jpconstantineau/PyKey60/pykey87/PCB-design/PyKey87.kicad_pcb

## KiCad design pykey87/PCB-design/PyKey87.kicad_pcb (2022-02-04)

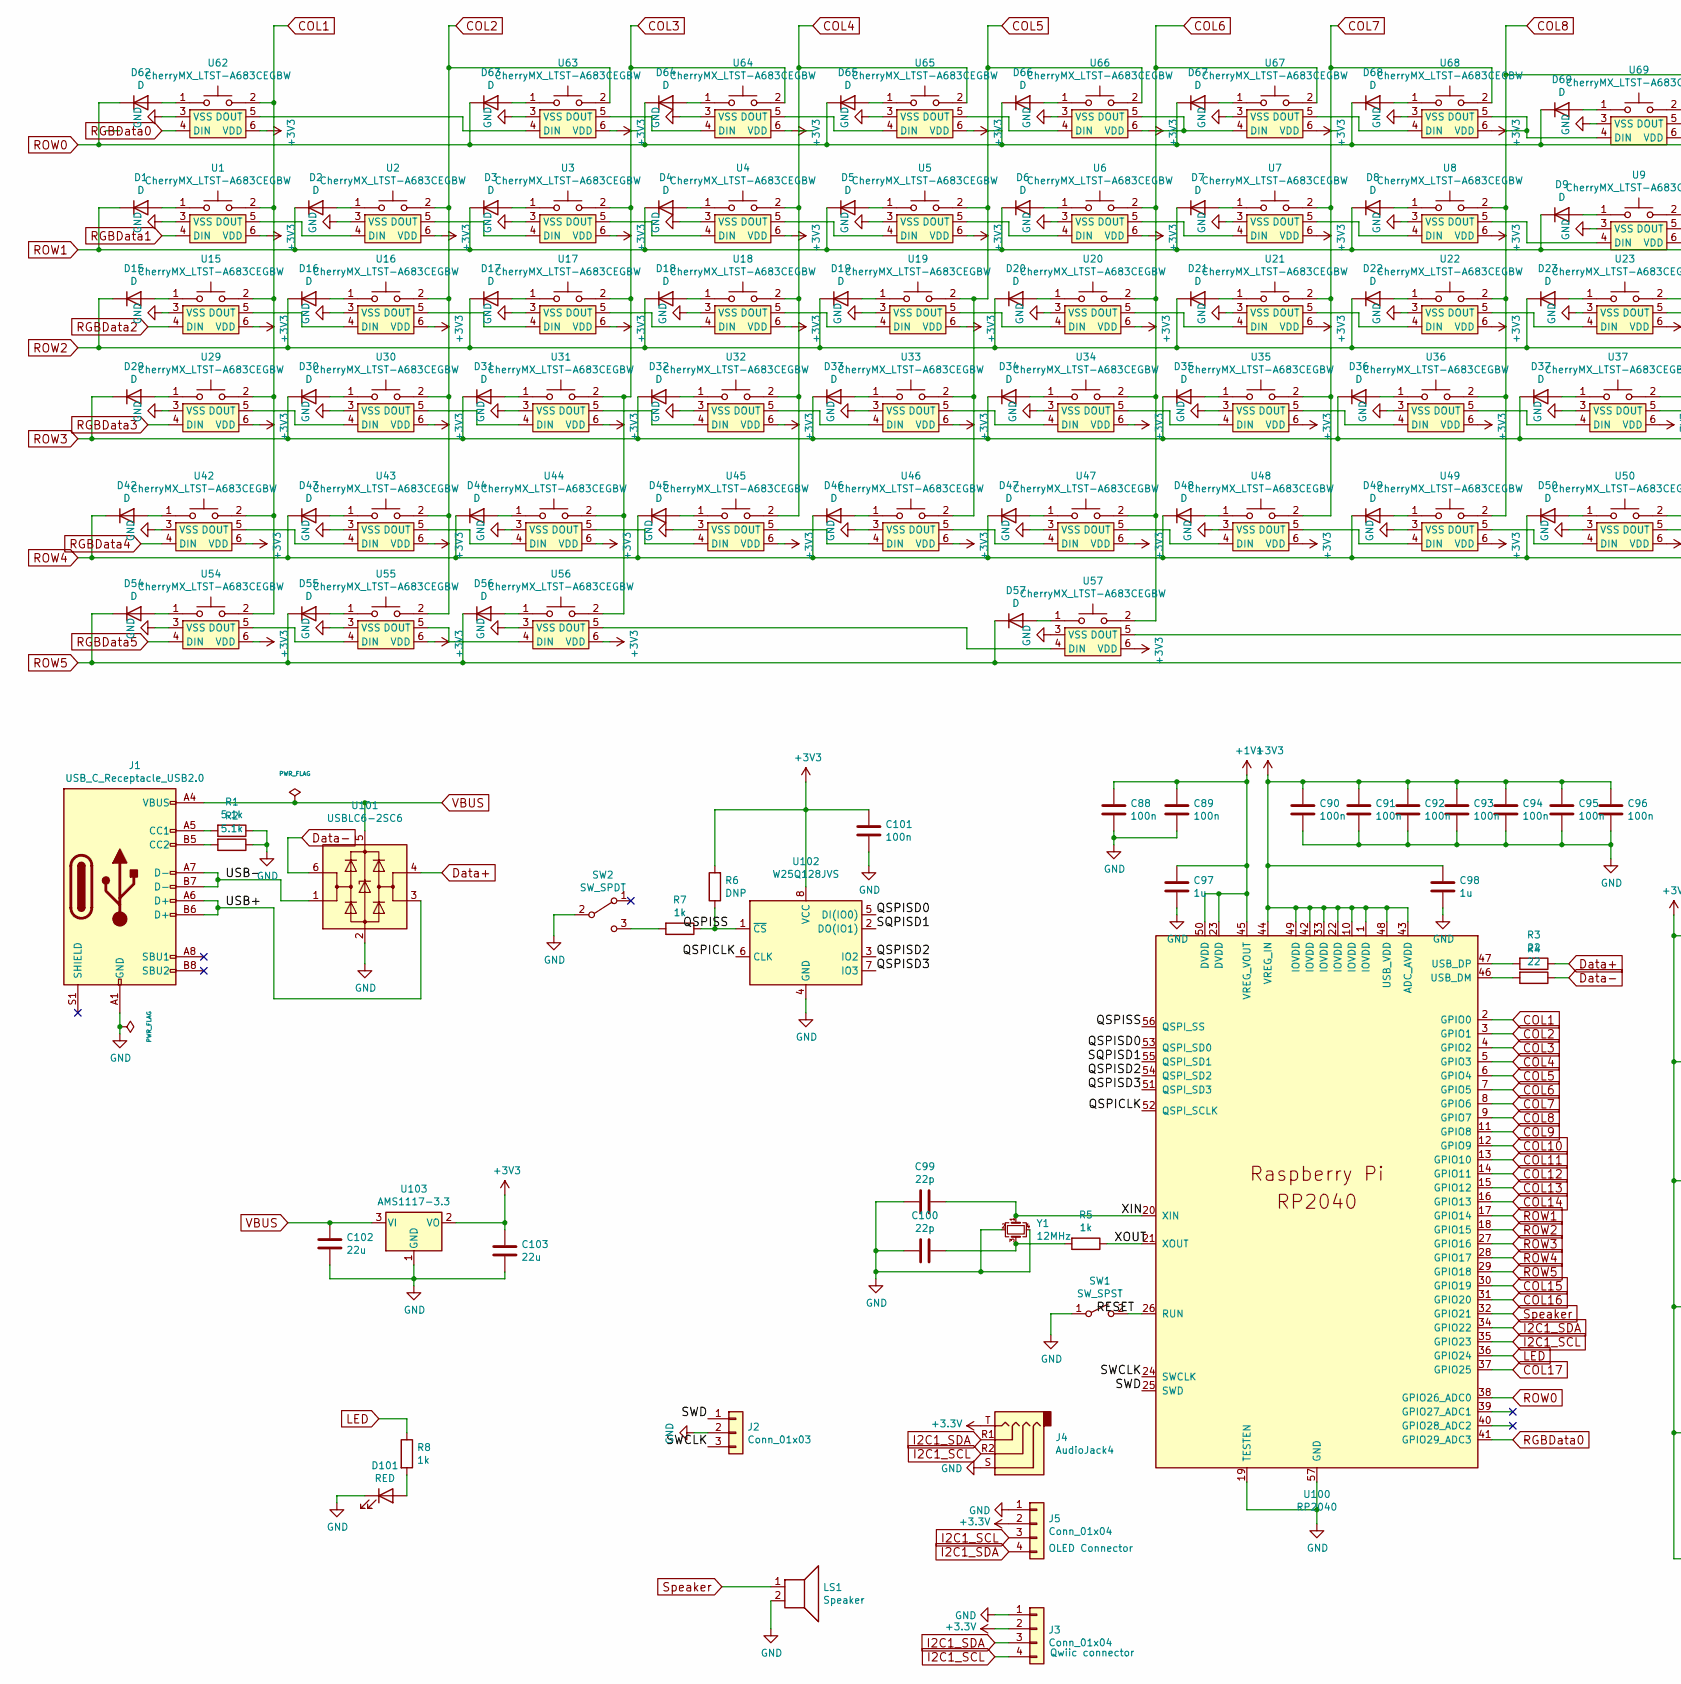
[picture p1: schematic PyKey87.sch, PyKey87 RP2040, part in row 1, column 1]

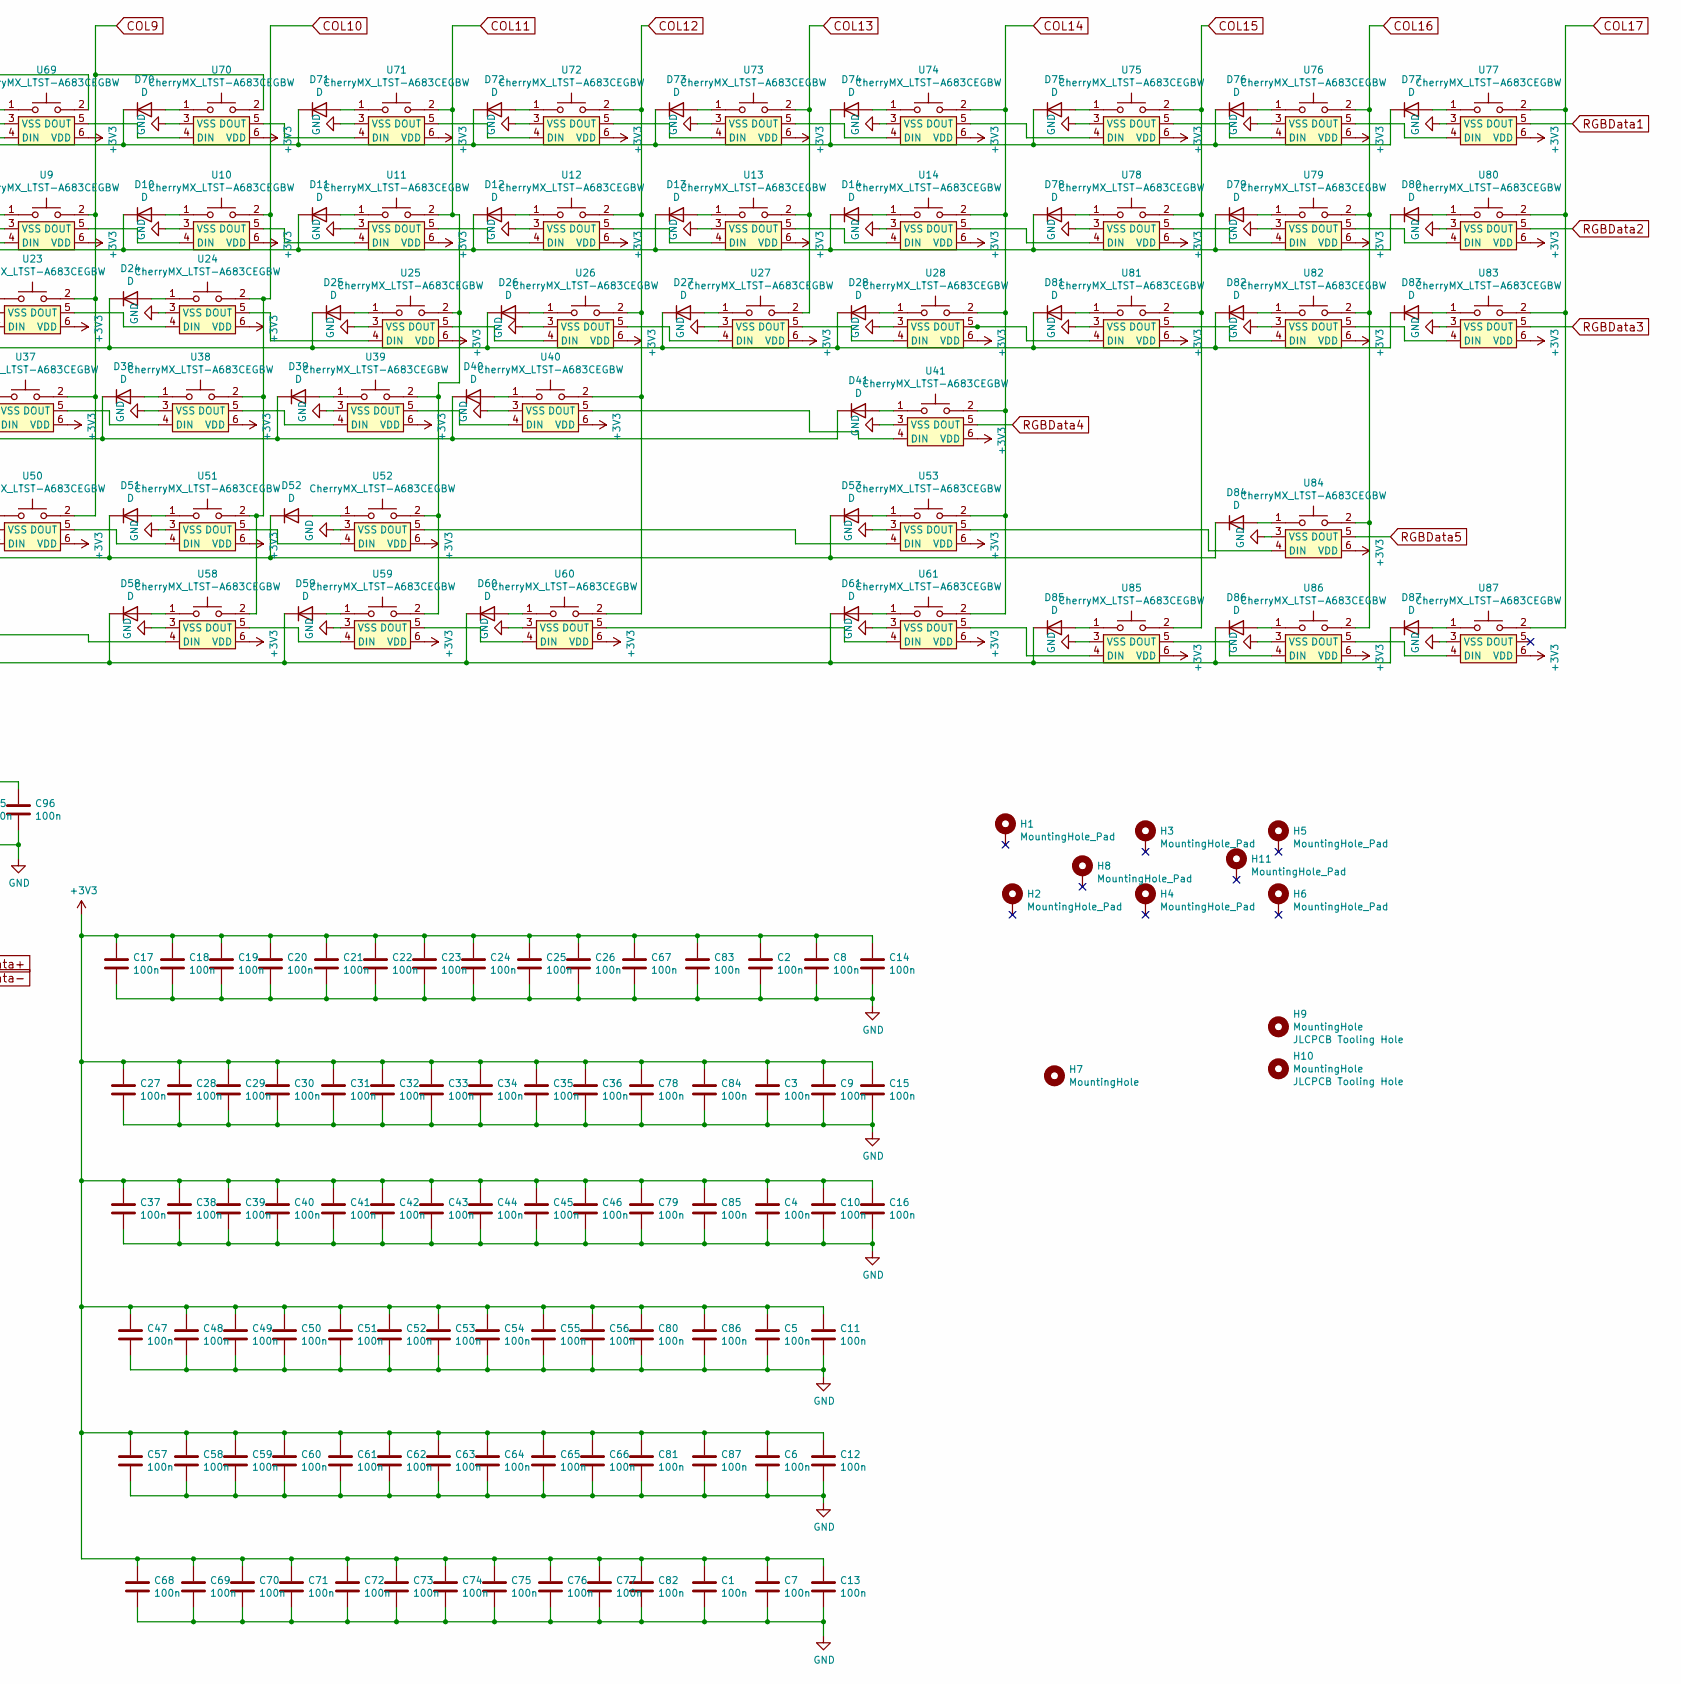
[picture p2: schematic PyKey87.sch, PyKey87 RP2040, part in row 1, column 2]

Parts:
C1, C2, C3, C4, C5, C6, C7, C8, C9, C10, C11, C12, C13, C14, C15, C16, C17, C18, C19, C20, C21, C22, C23, C24, C25, C26, C27, C28, C29, C30, C31, C32, C33, C34, C35, C36, C37, C38, C39, C40, C41, C42, C43, C44, C45, C46, C47, C48, C49, C50, C51, C52, C53, C54, C55, C56, C57, C58, C59, C60, C61, C62, C63, C64, C65, C66, C67, C68, C69, C70, C71, C72, C73, C74, C75, C76, C77, C78, C79, C80, C81, C82, C83, C84, C85, C86, C87, C88, C89, C90, C91, C92, C93, C94, C95, C96, C101: 100n; C_0603_1608Metric; LCSC C14663
C97, C98: 1u; C_0603_1608Metric; LCSC C15849
C99, C100: 22p; C_0603_1608Metric; LCSC C1653
C102, C103: 22u; C_0603_1608Metric; LCSC C59461
D1, D2, D3, D4, D5, D6, D7, D8, D9, D10, D11, D12, D13, D14, D15, D16, D17, D18, D19, D20, D21, D22, D23, D24, D25, D26, D27, D28, D29, D30, D31, D32, D33, D34, D35, D36, D37, D38, D39, D40, D41, D42, D43, D44, D45, D46, D47, D48, D49, D50, D51, D52, D53, D54, D55, D56, D57, D58, D59, D60, D61, D62, D63, D64, D65, D66, D67, D68, D69, D70, D71, D72, D73, D74, D75, D76, D77, D78, D79, D80, D81, D82, D83, D84, D85, D86, D87: D; D_SOD-123; LCSC C81598
D101: RED; LED_0603_1608Metric; LCSC C2286
H1, H2, H3, H4, H5, H6, H8, H11: MountingHole_Pad; MountingHole_2.2mm_M2_Pad
H7: MountingHole; KB_BlueMicro
H9, H10: MountingHole; MountingHole_1.152mm
J1: USB_C_Receptacle_USB2.0; USB_C_Receptacle_HRO_TYPE-C-31-M-12
J2: Conn_01x03; PinHeader_1x03_P2.54mm_Vertical
J3: Conn_01x04; JST_SH_SM04B-SRSS-TB_1x04-1MP_P1.00mm_Horizontal
J4: AudioJack4; Jack_3.5mm_PJ320D_Horizontal; LCSC C521460
J5: Conn_01x04; PinHeader_1x04_P2.54mm_Vertical
LS1: Speaker; AST1109MLTRQ; LCSC C6186
R1, R2: 5.1k; R_0603_1608Metric; LCSC C23186
R3, R4: 22; R_0603_1608Metric; LCSC C23345
R5, R7, R8: 1k; R_0603_1608Metric; LCSC C21190
R6: DNP; R_0603_1608Metric
SW1: SW_SPST; Panasonic_EVQPUL_EVQPUC; LCSC C388883
SW2: SW_SPDT; SW_SPDT_PCM12
U1, U2, U3, U4, U5, U6, U7, U8, U9, U10, U11, U12, U13, U16, U17, U18, U19, U20, U21, U22, U23, U24, U25, U26, U27, U30, U31, U32, U33, U34, U35, U36, U37, U38, U39, U40, U43, U44, U45, U46, U47, U48, U49, U50, U51, U52, U62, U63, U64, U65, U66, U67, U68, U69, U70, U71, U72, U73, U74, U75, U76, U77, U78, U79, U80, U81, U82, U83, U84, U85, U86, U87: CherryMX_LTST-A683CEGBW; CherryMX_1.00u_PCB_KailhSocket_LTST-A683CEGBW-Rotated-HS
U14: CherryMX_LTST-A683CEGBW; CherryMX_2.00u_PCB_KailhSocket_StabWireTop_LTST-A683CEGBW-R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
U15, U28: CherryMX_LTST-A683CEGBW; CherryMX_1.50u_PCB_KailhSocket_LTST-A683CEGBW-Rotated-HS
U29: CherryMX_LTST-A683CEGBW; CherryMX_1.75u_PCB_KailhSocket_LTST-A683CEGBW-Rotated-HS
U41, U42: CherryMX_LTST-A683CEGBW; CherryMX_2.25u_PCB_KailhSocket_StabWireBottom_LTST-A683CEGB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
U53: CherryMX_LTST-A683CEGBW; CherryMX_2.75u_PCB_KailhSocket_StabWireBottom_LTST-A683CEGB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
U54, U55, U56, U58, U59, U60, U61: CherryMX_LTST-A683CEGBW; CherryMX_1.25u_PCB_KailhSocket_LTST-A683CEGBW-Rotated-HS
U57: CherryMX_LTST-A683CEGBW; CherryMX_6.25u_PCB_KailhSocket_StabWireBottom_LTST-A683CEGB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
U100: RP2040; RP2040-QFN-56; LCSC C2040
U101: USBLC6-2SC6; SOT-23-6; LCSC C558442
U102: W25Q128JVS; SOIC-8_5.23x5.23mm_P1.27mm; LCSC C97521
U103: AMS1117-3.3; SOT-223-3_TabPin2; LCSC C6186
Y1: 12MHz; Crystal_SMD_3225-4Pin_3.2x2.5mm; LCSC C9002

Connections:
+1V1: C88.1, C89.1, C97.1, U100.23 (DVDD), U100.45 (VREG_VOUT), U100.50 (DVDD)
/QSPICLK: U100.52 (QSPI_SCLK), U102.6 (CLK)
/QSPISD0: U100.53 (QSPI_SD0), U102.5 (DI(IO0))
/QSPISD2: U100.54 (QSPI_SD2), U102.3 (IO2)
/QSPISD3: U100.51 (QSPI_SD3), U102.7 (IO3)
/QSPISS: R6.1, R7.1, U100.56 (QSPI_SS), U102.1 (~CS)
/RESET: SW1.2 (B), U100.26 (RUN)
/SQPISD1: U100.55 (QSPI_SD1), U102.2 (DO(IO1))
/SWCLK: J2.3, U100.24 (SWCLK)
/SWD: J2.1, U100.25 (SWD)
/USB+: J1.A6 (D+), J1.B6 (D+), U101.3 (I/O2)
/USB-: J1.A7 (D-), J1.B7 (D-), U101.1 (I/O1)
/XIN: C99.1, U100.20 (XIN), Y1.1
/XOUT: R5.1, U100.21 (XOUT)
COL1: U1.2, U15.2, U29.2, U42.2, U54.2, U62.2, U100.2 (GPIO0)
COL2: U2.2, U16.2, U30.2, U43.2, U55.2, U63.2, U100.3 (GPIO1)
COL3: U3.2, U17.2, U31.2, U44.2, U56.2, U64.2, U100.4 (GPIO2)
COL4: U4.2, U18.2, U32.2, U45.2, U65.2, U100.5 (GPIO3)
COL5: U5.2, U19.2, U33.2, U46.2, U66.2, U100.6 (GPIO4)
COL6: U6.2, U20.2, U34.2, U47.2, U57.2, U67.2, U100.7 (GPIO5)
COL7: U7.2, U21.2, U35.2, U48.2, U68.2, U100.8 (GPIO6)
COL8: U8.2, U22.2, U36.2, U49.2, U69.2, U100.9 (GPIO7)
COL9: U9.2, U23.2, U37.2, U50.2, U70.2, U100.11 (GPIO8)
COL10: U10.2, U24.2, U38.2, U51.2, U58.2, U100.12 (GPIO9)
COL11: U11.2, U25.2, U39.2, U52.2, U59.2, U71.2, U100.13 (GPIO10)
COL12: U12.2, U26.2, U40.2, U60.2, U72.2, U100.14 (GPIO11)
COL13: U13.2, U27.2, U73.2, U100.15 (GPIO12)
COL14: U14.2, U28.2, U41.2, U53.2, U61.2, U74.2, U100.16 (GPIO13)
COL15: U75.2, U78.2, U81.2, U85.2, U100.30 (GPIO19)
COL16: U76.2, U79.2, U82.2, U84.2, U86.2, U100.31 (GPIO20)
COL17: U77.2, U80.2, U83.2, U87.2, U100.37 (GPIO25)
Data+: R3.1, U101.4 (I/O2)
Data-: R4.1, U101.6 (I/O1)
GND: C1.2, C2.2, C3.2, C4.2, C5.2, C6.2, C7.2, C8.2, C9.2, C10.2, C11.2, C12.2, C13.2, C14.2, C15.2, C16.2, C17.2, C18.2, C19.2, C20.2, C21.2, C22.2, C23.2, C24.2, C25.2, C26.2, C27.2, C28.2, C29.2, C30.2, C31.2, C32.2, C33.2, C34.2, C35.2, C36.2, C37.2, C38.2, C39.2, C40.2, C41.2, C42.2, C43.2, C44.2, C45.2, C46.2, C47.2, C48.2, C49.2, C50.2, C51.2, C52.2, C53.2, C54.2, C55.2, C56.2, C57.2, C58.2, C59.2, C60.2, C61.2, C62.2, C63.2, C64.2, C65.2, C66.2, C67.2, C68.2, C69.2, C70.2, C71.2, C72.2, C73.2, C74.2, C75.2, C76.2, C77.2, C78.2, C79.2, C80.2, C81.2, C82.2, C83.2, C84.2, C85.2, C86.2, C87.2, C88.2, C89.2, C90.2, C91.2, C92.2, C93.2, C94.2, C95.2, C96.2, C97.2, C98.2, C99.2, C100.2, C101.2, C102.2, C103.2, D101.1 (K), J1.A1 (GND), J1.A12 (GND), J1.B1 (GND), J1.B12 (GND), J2.2, J3.1, J4.S, J5.1, LS1.2, R1.1, R2.1, SW1.1 (A), SW2.2 (B), U1.3 (VSS), U2.3 (VSS), U3.3 (VSS), U4.3 (VSS), U5.3 (VSS), U6.3 (VSS), U7.3 (VSS), U8.3 (VSS), U9.3 (VSS), U10.3 (VSS), U11.3 (VSS), U12.3 (VSS), U13.3 (VSS), U14.3 (VSS), U15.3 (VSS), U16.3 (VSS), U17.3 (VSS), U18.3 (VSS), U19.3 (VSS), U20.3 (VSS), U21.3 (VSS), U22.3 (VSS), U23.3 (VSS), U24.3 (VSS), U25.3 (VSS), U26.3 (VSS), U27.3 (VSS), U28.3 (VSS), U29.3 (VSS), U30.3 (VSS), U31.3 (VSS), U32.3 (VSS), U33.3 (VSS), U34.3 (VSS), U35.3 (VSS), U36.3 (VSS), U37.3 (VSS), U38.3 (VSS), U39.3 (VSS), U40.3 (VSS), U41.3 (VSS), U42.3 (VSS), U43.3 (VSS), U44.3 (VSS), U45.3 (VSS), U46.3 (VSS), U47.3 (VSS), U48.3 (VSS), U49.3 (VSS), U50.3 (VSS), U51.3 (VSS), U52.3 (VSS), U53.3 (VSS), U54.3 (VSS), U55.3 (VSS), U56.3 (VSS), U57.3 (VSS), U58.3 (VSS), U59.3 (VSS), U60.3 (VSS), U61.3 (VSS), U62.3 (VSS), U63.3 (VSS), U64.3 (VSS), U65.3 (VSS), U66.3 (VSS), U67.3 (VSS), U68.3 (VSS), U69.3 (VSS), U70.3 (VSS), U71.3 (VSS), U72.3 (VSS), U73.3 (VSS), U74.3 (VSS), U75.3 (VSS), U76.3 (VSS), U77.3 (VSS), U78.3 (VSS), U79.3 (VSS), U80.3 (VSS), U81.3 (VSS), U82.3 (VSS), U83.3 (VSS), U84.3 (VSS), U85.3 (VSS), U86.3 (VSS), U87.3 (VSS), U100.19 (TESTEN), U100.57 (GND), U101.2 (GND), U102.4 (GND), U103.1 (GND), Y1.2, Y1.4
I2C1_SCL: J3.4, J4.R2, J5.3, U100.35 (GPIO23)
I2C1_SDA: J3.3, J4.R1, J5.4, U100.34 (GPIO22)
LED: R8.1, U100.36 (GPIO24)
unnamed: C100.1, R5.2, Y1.3
unnamed: D1.2 (A), U1.1
unnamed: D2.2 (A), U2.1
unnamed: D3.2 (A), U3.1
unnamed: D4.2 (A), U4.1
unnamed: D5.2 (A), U5.1
unnamed: D6.2 (A), U6.1
unnamed: D7.2 (A), U7.1
unnamed: D8.2 (A), U8.1
unnamed: D9.2 (A), U9.1
unnamed: D10.2 (A), U10.1
unnamed: D11.2 (A), U11.1
unnamed: D12.2 (A), U12.1
unnamed: D13.2 (A), U13.1
unnamed: D14.2 (A), U14.1
unnamed: D15.2 (A), U15.1
unnamed: D16.2 (A), U16.1
unnamed: D17.2 (A), U17.1
unnamed: D18.2 (A), U18.1
unnamed: D19.2 (A), U19.1
unnamed: D20.2 (A), U20.1
unnamed: D21.2 (A), U21.1
unnamed: D22.2 (A), U22.1
unnamed: D23.2 (A), U23.1
unnamed: D24.2 (A), U24.1
unnamed: D25.2 (A), U25.1
unnamed: D26.2 (A), U26.1
unnamed: D27.2 (A), U27.1
unnamed: D28.2 (A), U28.1
unnamed: D29.2 (A), U29.1
unnamed: D30.2 (A), U30.1
unnamed: D31.2 (A), U31.1
unnamed: D32.2 (A), U32.1
unnamed: D33.2 (A), U33.1
unnamed: D34.2 (A), U34.1
unnamed: D35.2 (A), U35.1
unnamed: D36.2 (A), U36.1
unnamed: D37.2 (A), U37.1
unnamed: D38.2 (A), U38.1
unnamed: D39.2 (A), U39.1
unnamed: D40.2 (A), U40.1
unnamed: D41.2 (A), U41.1
unnamed: D42.2 (A), U42.1
unnamed: D43.2 (A), U43.1
unnamed: D44.2 (A), U44.1
unnamed: D45.2 (A), U45.1
unnamed: D46.2 (A), U46.1
unnamed: D47.2 (A), U47.1
unnamed: D48.2 (A), U48.1
unnamed: D49.2 (A), U49.1
unnamed: D50.2 (A), U50.1
unnamed: D51.2 (A), U51.1
unnamed: D52.2 (A), U52.1
unnamed: D53.2 (A), U53.1
unnamed: D54.2 (A), U54.1
unnamed: D55.2 (A), U55.1
unnamed: D56.2 (A), U56.1
unnamed: D57.2 (A), U57.1
unnamed: D58.2 (A), U58.1
unnamed: D59.2 (A), U59.1
unnamed: D60.2 (A), U60.1
unnamed: D61.2 (A), U61.1
unnamed: D62.2 (A), U62.1
unnamed: D63.2 (A), U63.1
unnamed: D64.2 (A), U64.1
unnamed: D65.2 (A), U65.1
unnamed: D66.2 (A), U66.1
unnamed: D67.2 (A), U67.1
unnamed: D68.2 (A), U68.1
unnamed: D69.2 (A), U69.1
unnamed: D70.2 (A), U70.1
unnamed: D71.2 (A), U71.1
unnamed: D72.2 (A), U72.1
unnamed: D73.2 (A), U73.1
unnamed: D74.2 (A), U74.1
unnamed: D75.2 (A), U75.1
unnamed: D76.2 (A), U76.1
unnamed: D77.2 (A), U77.1
unnamed: D78.2 (A), U78.1
unnamed: D79.2 (A), U79.1
unnamed: D80.2 (A), U80.1
unnamed: D81.2 (A), U81.1
unnamed: D82.2 (A), U82.1
unnamed: D83.2 (A), U83.1
unnamed: D84.2 (A), U84.1
unnamed: D85.2 (A), U85.1
unnamed: D86.2 (A), U86.1
unnamed: D87.2 (A), U87.1
unnamed: D101.2 (A), R8.2
unnamed: J1.A5 (CC1), R1.2
unnamed: J1.B5 (CC2), R2.2
unnamed: R3.2, U100.47 (USB_DP)
unnamed: R4.2, U100.46 (USB_DM)
unnamed: R7.2, SW2.3 (C)
unnamed: U1.5 (DOUT), U2.4 (DIN)
unnamed: U2.5 (DOUT), U3.4 (DIN)
unnamed: U3.5 (DOUT), U4.4 (DIN)
unnamed: U4.5 (DOUT), U5.4 (DIN)
unnamed: U5.5 (DOUT), U6.4 (DIN)
unnamed: U6.5 (DOUT), U7.4 (DIN)
unnamed: U7.5 (DOUT), U8.4 (DIN)
unnamed: U8.5 (DOUT), U9.4 (DIN)
unnamed: U9.5 (DOUT), U10.4 (DIN)
unnamed: U10.5 (DOUT), U11.4 (DIN)
unnamed: U11.5 (DOUT), U12.4 (DIN)
unnamed: U12.5 (DOUT), U13.4 (DIN)
unnamed: U13.5 (DOUT), U14.4 (DIN)
unnamed: U14.5 (DOUT), U78.4 (DIN)
unnamed: U15.5 (DOUT), U16.4 (DIN)
unnamed: U16.5 (DOUT), U17.4 (DIN)
unnamed: U17.5 (DOUT), U18.4 (DIN)
unnamed: U18.5 (DOUT), U19.4 (DIN)
unnamed: U19.5 (DOUT), U20.4 (DIN)
unnamed: U20.5 (DOUT), U21.4 (DIN)
unnamed: U21.5 (DOUT), U22.4 (DIN)
unnamed: U22.5 (DOUT), U23.4 (DIN)
unnamed: U23.5 (DOUT), U24.4 (DIN)
unnamed: U24.5 (DOUT), U25.4 (DIN)
unnamed: U25.5 (DOUT), U26.4 (DIN)
unnamed: U26.5 (DOUT), U27.4 (DIN)
unnamed: U27.5 (DOUT), U28.4 (DIN)
unnamed: U28.5 (DOUT), U81.4 (DIN)
unnamed: U29.5 (DOUT), U30.4 (DIN)
unnamed: U30.5 (DOUT), U31.4 (DIN)
unnamed: U31.5 (DOUT), U32.4 (DIN)
unnamed: U32.5 (DOUT), U33.4 (DIN)
unnamed: U33.5 (DOUT), U34.4 (DIN)
unnamed: U34.5 (DOUT), U35.4 (DIN)
unnamed: U35.5 (DOUT), U36.4 (DIN)
unnamed: U36.5 (DOUT), U37.4 (DIN)
unnamed: U37.5 (DOUT), U38.4 (DIN)
unnamed: U38.5 (DOUT), U39.4 (DIN)
unnamed: U39.5 (DOUT), U40.4 (DIN)
unnamed: U40.5 (DOUT), U41.4 (DIN)
unnamed: U42.5 (DOUT), U43.4 (DIN)
unnamed: U43.5 (DOUT), U44.4 (DIN)
unnamed: U44.5 (DOUT), U45.4 (DIN)
unnamed: U45.5 (DOUT), U46.4 (DIN)
unnamed: U46.5 (DOUT), U47.4 (DIN)
unnamed: U47.5 (DOUT), U48.4 (DIN)
unnamed: U48.5 (DOUT), U49.4 (DIN)
unnamed: U49.5 (DOUT), U50.4 (DIN)
unnamed: U50.5 (DOUT), U51.4 (DIN)
unnamed: U51.5 (DOUT), U52.4 (DIN)
unnamed: U52.5 (DOUT), U53.4 (DIN)
unnamed: U53.5 (DOUT), U84.4 (DIN)
unnamed: U54.5 (DOUT), U55.4 (DIN)
unnamed: U55.5 (DOUT), U56.4 (DIN)
unnamed: U56.5 (DOUT), U57.4 (DIN)
unnamed: U57.5 (DOUT), U58.4 (DIN)
unnamed: U58.5 (DOUT), U59.4 (DIN)
unnamed: U59.5 (DOUT), U60.4 (DIN)
unnamed: U60.5 (DOUT), U61.4 (DIN)
unnamed: U61.5 (DOUT), U85.4 (DIN)
unnamed: U62.5 (DOUT), U63.4 (DIN)
unnamed: U63.5 (DOUT), U64.4 (DIN)
unnamed: U64.5 (DOUT), U65.4 (DIN)
unnamed: U65.5 (DOUT), U66.4 (DIN)
unnamed: U66.5 (DOUT), U67.4 (DIN)
unnamed: U67.5 (DOUT), U68.4 (DIN)
unnamed: U68.5 (DOUT), U69.4 (DIN)
unnamed: U69.5 (DOUT), U70.4 (DIN)
unnamed: U70.5 (DOUT), U71.4 (DIN)
unnamed: U71.5 (DOUT), U72.4 (DIN)
unnamed: U72.5 (DOUT), U73.4 (DIN)
unnamed: U73.5 (DOUT), U74.4 (DIN)
unnamed: U74.5 (DOUT), U75.4 (DIN)
unnamed: U75.5 (DOUT), U76.4 (DIN)
unnamed: U76.5 (DOUT), U77.4 (DIN)
unnamed: U78.5 (DOUT), U79.4 (DIN)
unnamed: U79.5 (DOUT), U80.4 (DIN)
unnamed: U81.5 (DOUT), U82.4 (DIN)
unnamed: U82.5 (DOUT), U83.4 (DIN)
unnamed: U85.5 (DOUT), U86.4 (DIN)
unnamed: U86.5 (DOUT), U87.4 (DIN)
RGBData0: U62.4 (DIN), U100.41 (GPIO29_ADC3)
RGBData1: U1.4 (DIN), U77.5 (DOUT)
RGBData2: U15.4 (DIN), U80.5 (DOUT)
RGBData3: U29.4 (DIN), U83.5 (DOUT)
RGBData4: U41.5 (DOUT), U42.4 (DIN)
RGBData5: U54.4 (DIN), U84.5 (DOUT)
ROW0: D62.1 (K), D63.1 (K), D64.1 (K), D65.1 (K), D66.1 (K), D67.1 (K), D68.1 (K), D69.1 (K), D70.1 (K), D71.1 (K), D72.1 (K), D73.1 (K), D74.1 (K), D75.1 (K), D76.1 (K), D77.1 (K), U100.38 (GPIO26_ADC0)
ROW1: D1.1 (K), D2.1 (K), D3.1 (K), D4.1 (K), D5.1 (K), D6.1 (K), D7.1 (K), D8.1 (K), D9.1 (K), D10.1 (K), D11.1 (K), D12.1 (K), D13.1 (K), D14.1 (K), D78.1 (K), D79.1 (K), D80.1 (K), U100.17 (GPIO14)
ROW2: D15.1 (K), D16.1 (K), D17.1 (K), D18.1 (K), D19.1 (K), D20.1 (K), D21.1 (K), D22.1 (K), D23.1 (K), D24.1 (K), D25.1 (K), D26.1 (K), D27.1 (K), D28.1 (K), D81.1 (K), D82.1 (K), D83.1 (K), U100.18 (GPIO15)
ROW3: D29.1 (K), D30.1 (K), D31.1 (K), D32.1 (K), D33.1 (K), D34.1 (K), D35.1 (K), D36.1 (K), D37.1 (K), D38.1 (K), D39.1 (K), D40.1 (K), D41.1 (K), U100.27 (GPIO16)
ROW4: D42.1 (K), D43.1 (K), D44.1 (K), D45.1 (K), D46.1 (K), D47.1 (K), D48.1 (K), D49.1 (K), D50.1 (K), D51.1 (K), D52.1 (K), D53.1 (K), D84.1 (K), U100.28 (GPIO17)
ROW5: D54.1 (K), D55.1 (K), D56.1 (K), D57.1 (K), D58.1 (K), D59.1 (K), D60.1 (K), D61.1 (K), D85.1 (K), D86.1 (K), D87.1 (K), U100.29 (GPIO18)
Speaker: LS1.1, U100.32 (GPIO21)
VBUS: C102.1, J1.A4 (VBUS), J1.A9 (VBUS), J1.B4 (VBUS), J1.B9 (VBUS), U101.5 (VBUS), U103.3 (VI)

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
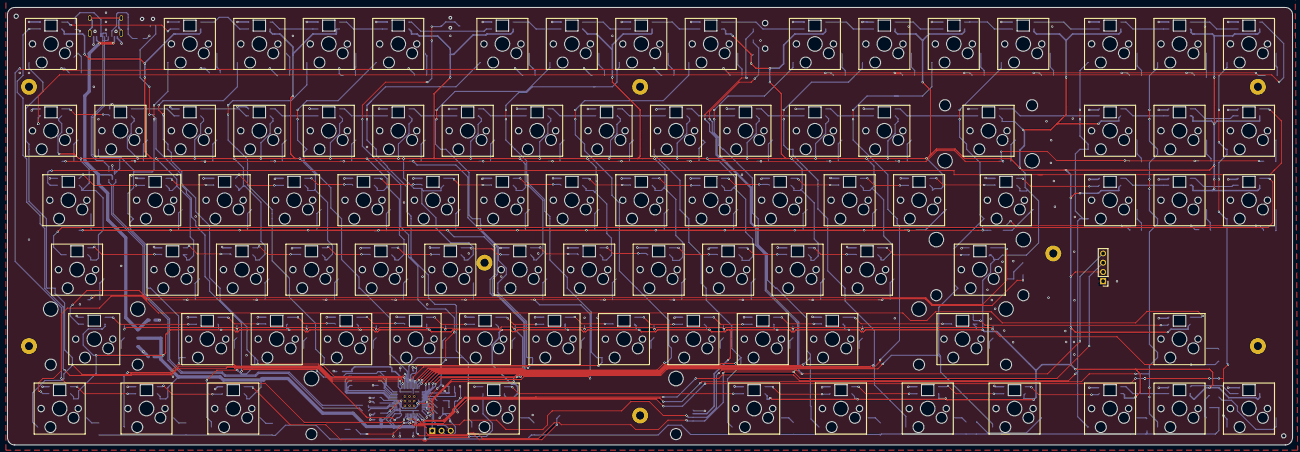
[picture p3: board PyKey87.kicad_pcb from above]

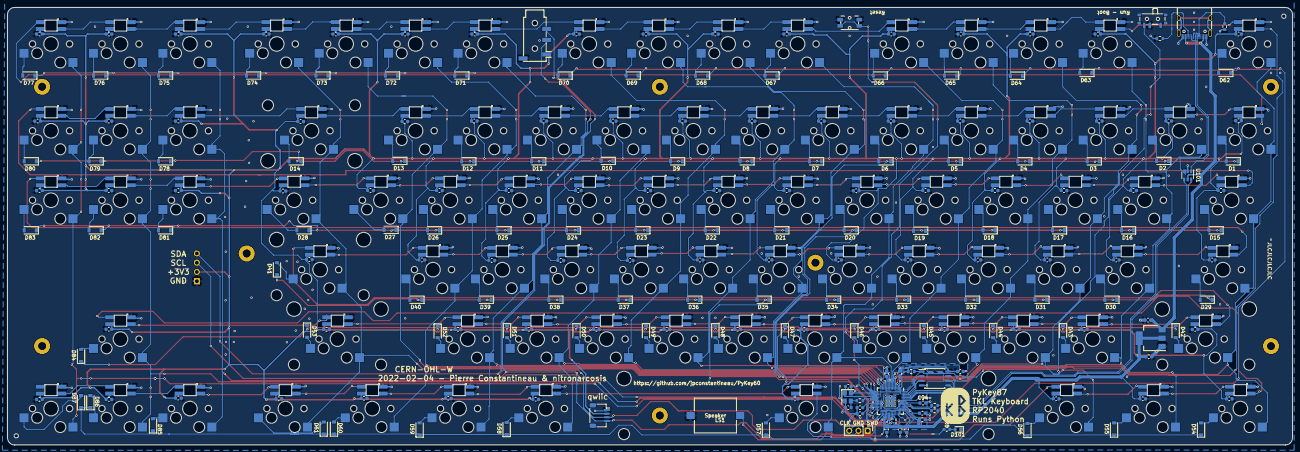
[picture p4: board PyKey87.kicad_pcb from below]

Board: 2 copper layers, 352.5 x 120.0 mm, 310 parts (212 on the bottom side), 227 nets.
