jpconstantineau/PyKey60/(notices)

Notices in the files:
pykey18/switch-plate/PyKey18/RP2040.sch:
License: CERN-OHL-W (CERN OHL v2)
pykey87/PCB-design/PyKey87.kicad_pcb:
CERN-OHL-W
